Sebas-Muriel/WarehouseRobot/Helpful Documents/Useful_links.txt

https://pinout.xyz/pinout/i2c
Useful for looking at the pinout diagrams for the Pi. This specific page is for I2C.

https://www.teachmemicro.com/raspberry-pi-serial-uart-tutorial/
Raspberry Pi QR scan code: 
https://www.hackster.io/gatoninja236/scan-qr-codes-in-real-time-with-raspberry-pi-a5268b

To get Camera working use this in terminal:

sudo chmod a+rw /dev/i2c-*
