Sebas-Muriel/WarehouseRobot/Senior Design Webmaster/vdrs/VDR3.pptx

Team Members: Alexandar Jen, Walter Caldwell, Sebastian Muriel, Tiffany Miller, Tony Zheng
Instructors: Dr. Oscar Chuy & Dr. Jerris Hooker Faculty Advisor: Dr. Bruce Harvey

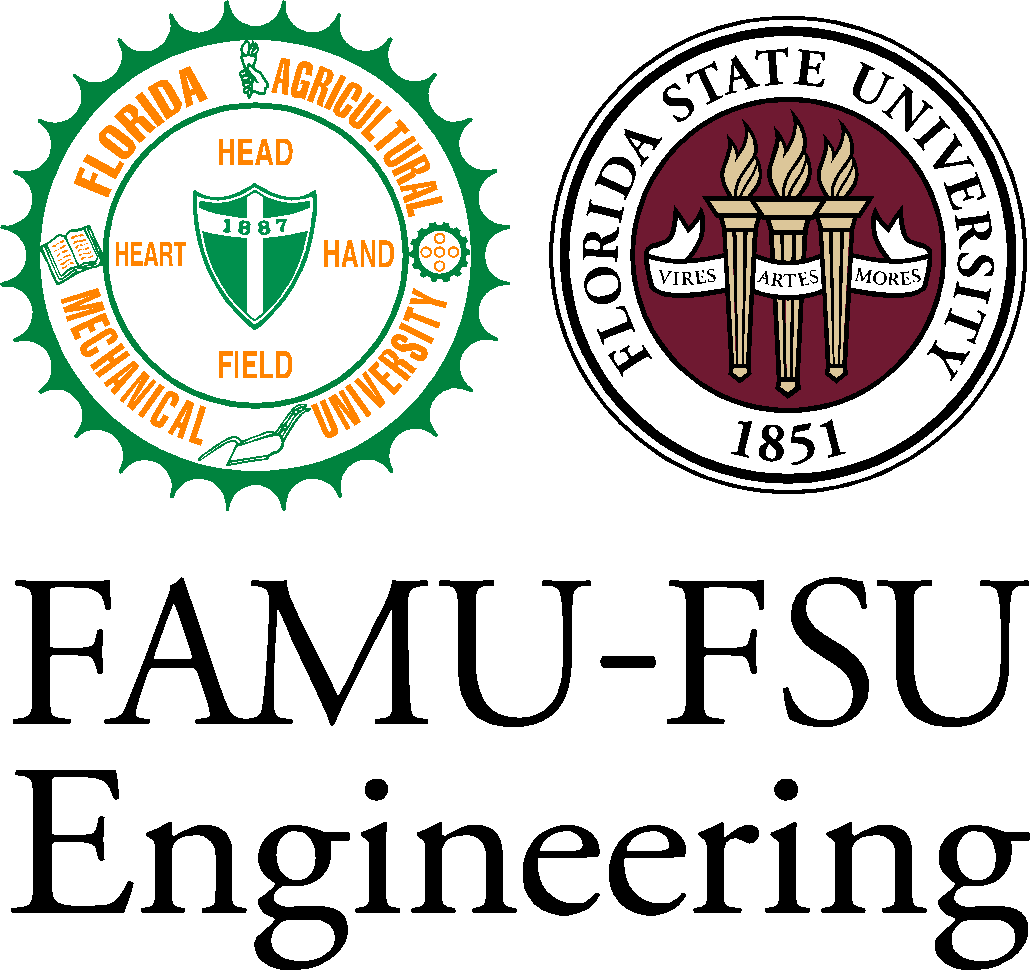
[picture p10: figure]

T311 - Material Handling Robot

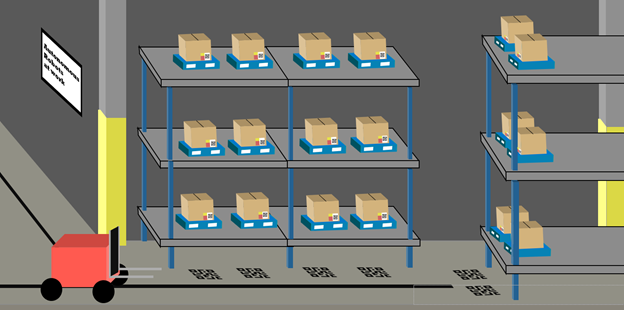
[picture p11: figure]

Objective:
The objective of this project is to create a partially autonomous material handling robot that works in a dark warehouse with conditions unfavorable to human workers.

Abstract

There is a demand for robotic workers in warehouses for the purpose of increasing productivity and reducing worker liability. Since the main goal is to reduce the number of human workers to zero, an autonomous fleet of robots is an ideal workforce. Thus, the purpose of this project is to create an autonomous robot that can manipulate inventory around the warehouse.

Design

An Arduino Due will be used to control the motors
A raspberry pi will be used to control navigation with a line sensor. It will also control the camera module to identify packages and update inventory.

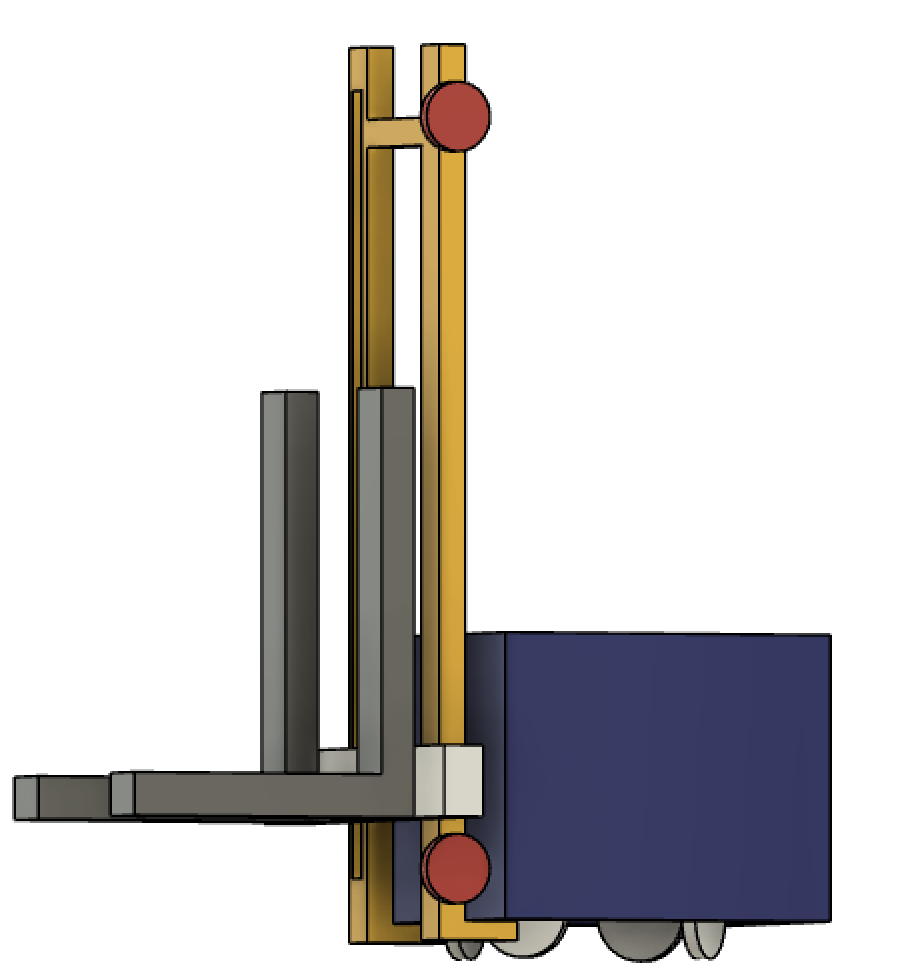
[picture p12: figure]

Problem

- Warehouses need to increase productivity to meet increasing demands.
- Worker injuries need to be reduced as well as employee turnover.
- Current robotic alternatives are expensive and too large.

Block Diagram

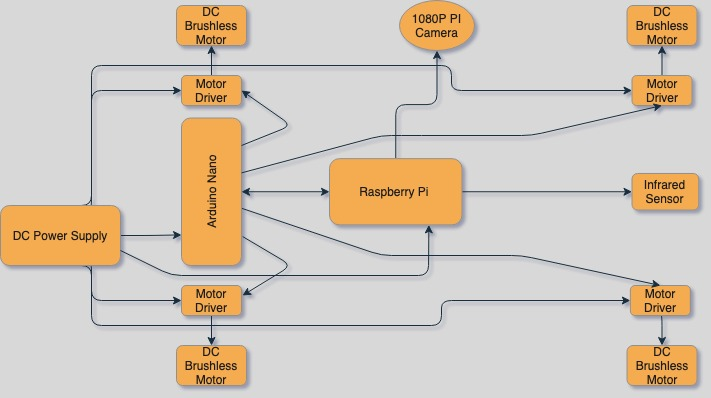
[picture p13: figure]

Scope

Load of 25 lb
Navigates autonomously
Recognizes packages
Self-loading and dropoff

Future Work

- Assemble prototype
- Test prototype movement and lifting mechanisms with manual inputs
- Design navigation and databasing algorithms
- Test algorithms and prototype’s autonomous movements

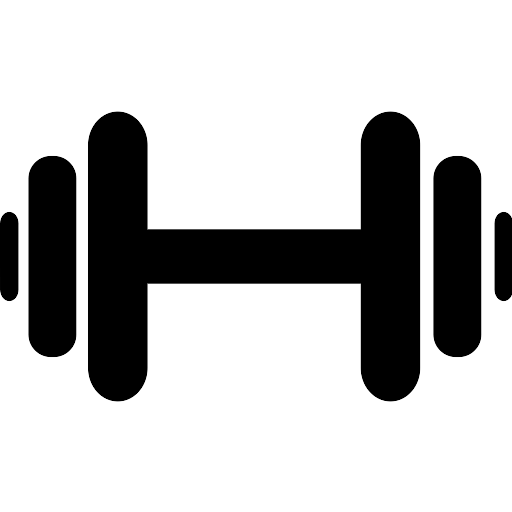
[picture p14: figure]
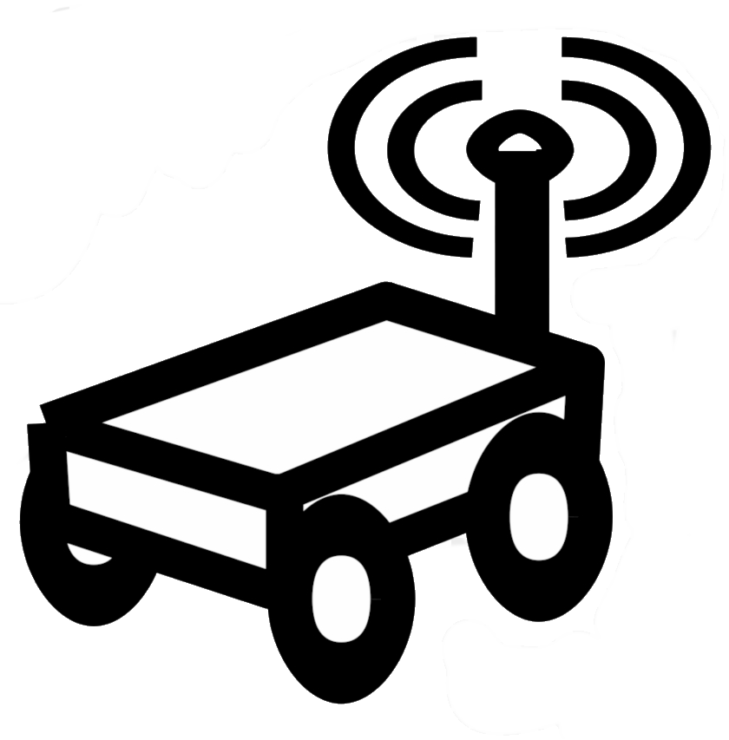
[picture p15: figure]
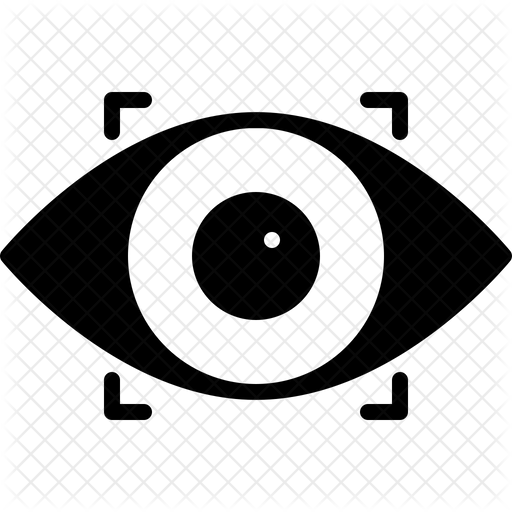
[picture p16: figure]
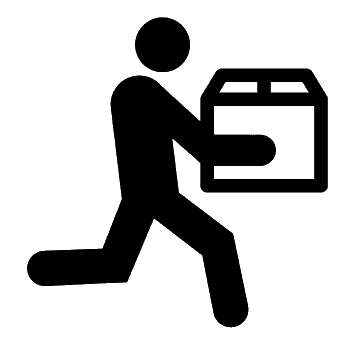
[picture p17: figure]

Notes: https://ww2.eng.famu.fsu.edu/me/senior_design/2017/team22/docs_pdfs/FinalPoster.pdf
