Sebas-Muriel/WarehouseRobot/Senior Design Webmaster/images/Chart.png

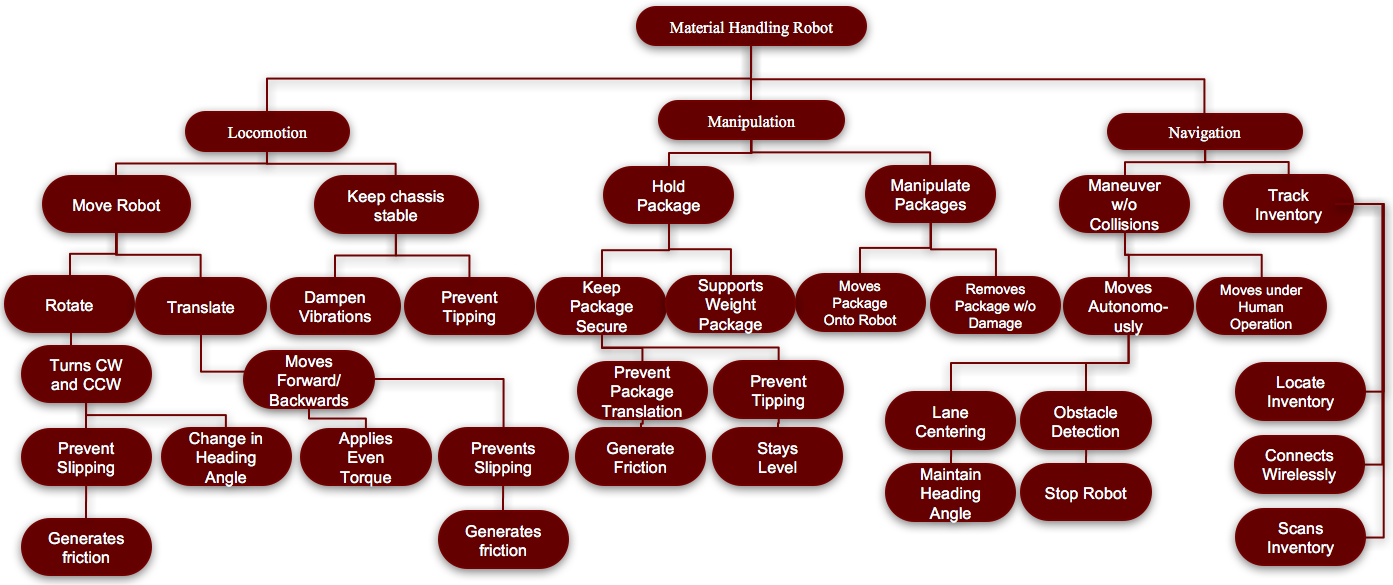
Senior Design Webmaster/images/Chart.png
