Sebas-Muriel/WarehouseRobot/Senior Design Webmaster/images/McConomy.png

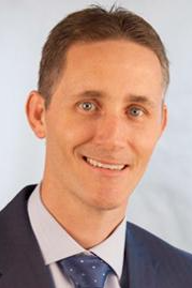
Senior Design Webmaster/images/McConomy.png
