Sebas-Muriel/WarehouseRobot/Senior Design Webmaster/images/NeedsTable.png

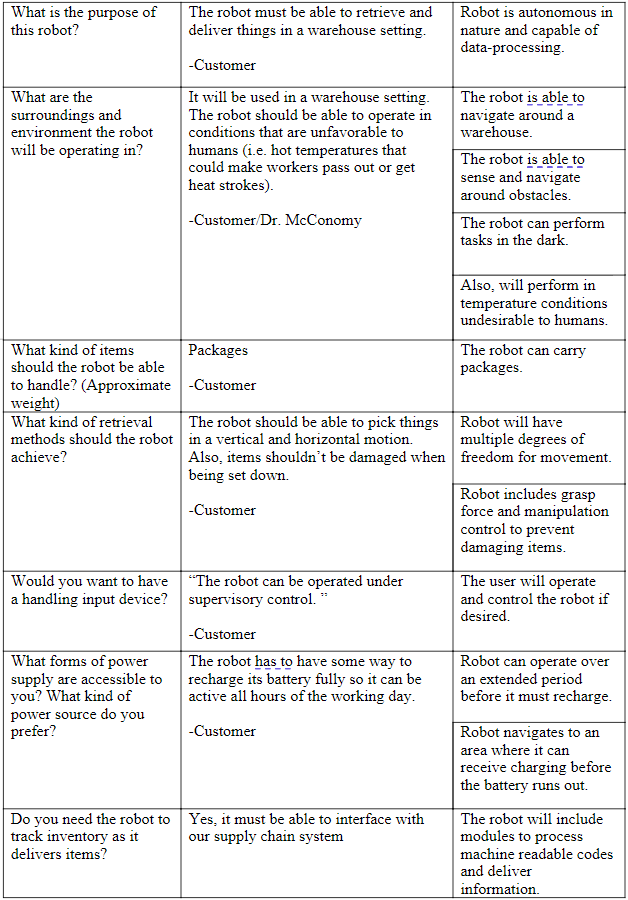
Senior Design Webmaster/images/NeedsTable.png
