Sebas-Muriel/WarehouseRobot/Senior Design Webmaster/images/Ordonez.png

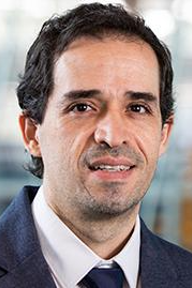
Senior Design Webmaster/images/Ordonez.png
