Sebas-Muriel/WarehouseRobot/Senior Design Webmaster/images/Robot.png

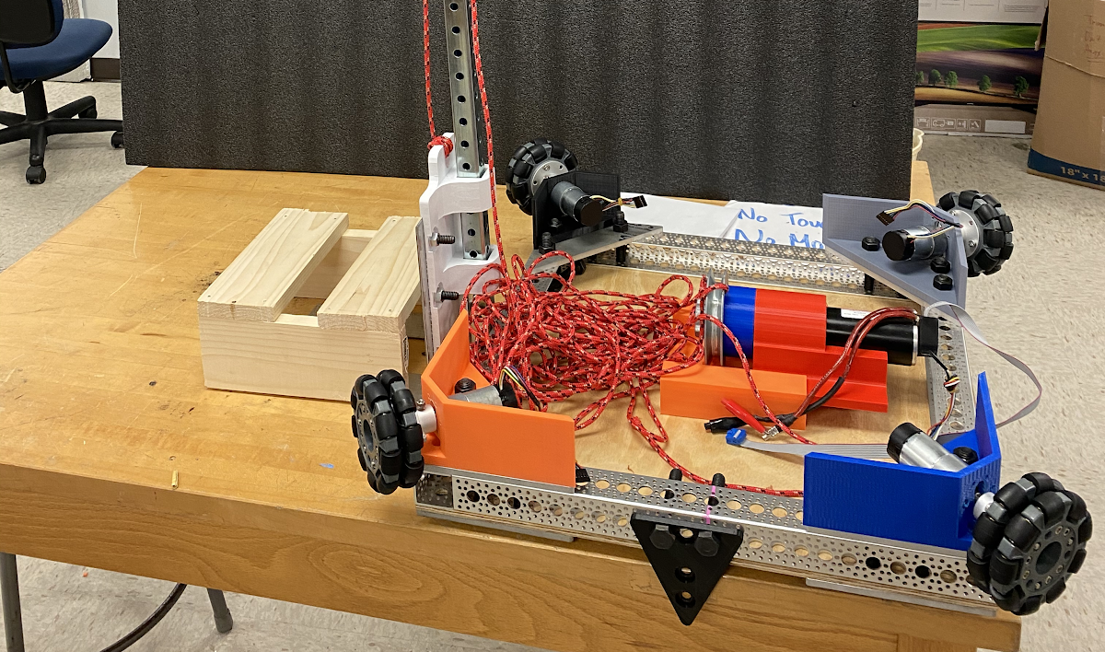
Senior Design Webmaster/images/Robot.png
