Sebas-Muriel/WarehouseRobot/Senior Design Webmaster/images/Targets.png

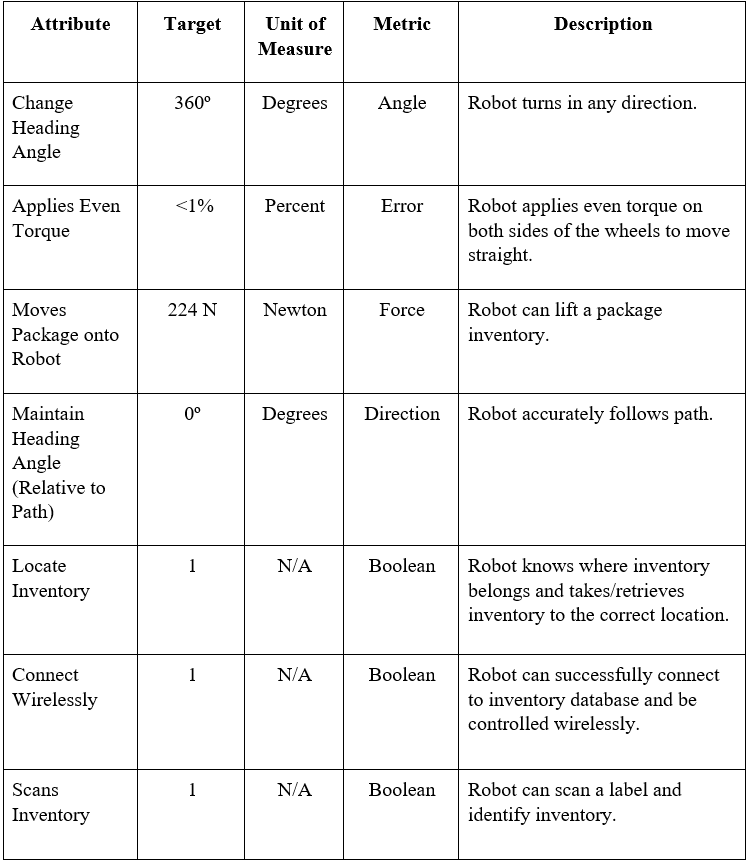
Senior Design Webmaster/images/Targets.png
