Sebas-Muriel/WarehouseRobot/MotorController/alex_omni/alex_omni.ino

#include "robot.h" // low level functions
#include <Time.h>
#include <TimeLib.h>
// Libraries:-
#include <Wire.h>

//Slave Addresses for I2C
#define IR_I2C 0x09

//Defines for movement
#define STOP 0x00
#define LEFT 0X01
#define RIGHT 0X02
#define UP 0x03
#define DOWN 0x04

#define RESET_MODE 0x00
//Defines for Modes 
#define NODE_MODE 0x01
#define TICK_MODE 0x02

//defines for pins
#define MRDY 0x06
#define SRDY 0x07
#define CAMLED 0x09
#define PILEDCONTROL 10

//defines for Motor Movement
#define MOTOR_STOP 0x00
#define MOTOR_LEVEL1 0x01
#define MOTOR_LEVEL2 0x02
  #define MOTOR_LEVEL3 0x04
  #define MOTOR_LIFT 0x03

#define BaseFloor .00
#define Floor1 .04
#define pickup .1

unsigned long ticks = 0; 

float goal[2] = {5.0, 0.0};

float vxMax = 0.15;      
float vyMax = 0.15;
float thetaDotMax = 1.00;

float count = 1;
float errorEnc0 = 0, errorEnc1 = 0;
float SumErrorEnc0 = 0, SumErrorEnc1 = 0;
float avgErrorEnc0 = errorEnc0, avgErrorEnc1 = errorEnc1;

uint8_t I2C_IR_Values[4] = {0,0,0,0};
uint8_t v_up[8], v_down[8], h_left[8], h_right[8], s_stop[8];
time_t start, current;
float xposStart = 0, xposCurrent = 0, yposStart = 0, yposCurrent = 0;
uint8_t NodeIntersectionFLG = 0, TickIntersectionFLG = 0, ForkFLG = 0;
char node = 'l', tick ='l';

float absforkLevel = .05;

uint8_t dir = STOP;
uint8_t motor = MOTOR_STOP;
uint8_t mode = RESET_MODE;
uint8_t UART_RX;
uint8_t MRDY_VAL;
char dirPID = 's';
char forkDir = 's';
uint8_t PiLED;

/*
 * UART_REC() 
 * Triggered by MRDY and reads the 8bit message that the PI sends.
 * It then parses that message and stores the data into dir/mode/motor
*/
void UART_REC();
/*
 * binToArray
 * takes in an 8bit binary number and converts it to an array of 8 indexes.
 * It then filters the array for outlying 1's
 */
uint8_t binToArray(uint8_t bin, uint8_t * arr);
/*
 * UART_TX
 * Sends the message to the pi on the Serial cable.
 */
void UART_TX(uint8_t message);
/*
 * Control
 * Runs the Omniwheel PI controls to move the robot.
 * Takes in a front and back sensor for line sensing PI controlls as well.
 */
void Control (uint8_t *front, char d, uint8_t *back);
/*
 * CopyArr
 * Takes in the src array and copies the values to the des array.
 */
void CopyArr(uint8_t *src, uint8_t *des);
/*
 * Array2Bin
 * Converts an array of 1's and 0's to an 8bit number containing the 1's and 0's.
 */
uint8_t Array2Bin(uint8_t values[]);
/*
 * lineLogic
 * returns true if it the line sensor reads any value with 0xF0 in it.
 */
bool lineLogic(uint8_t IR_Sens);

void setup() {
  Serial.begin(9600);
  Wire.begin();
  pinMode(MRDY, INPUT);
  attachInterrupt(digitalPinToInterrupt(MRDY), UART_REC, FALLING);
  pinMode(SRDY, OUTPUT);
  pinMode(CAMLED, OUTPUT);
  pinMode(PILEDCONTROL, INPUT);
  digitalWrite(CAMLED, HIGH);
  digitalWrite(SRDY, HIGH);
  startTimer(TC1, 0, TC3_IRQn, 100); //TC1 channel 0, the IRQ for that channel and the desired frequency
  encoder_init();
  pwm_init();
  // init sensor stuff

// Set pins connected to motor drivers as outputs (DUE version of DDRC)
  REG_PIOC_OWER = 0x00000FFF;     // Enable writes to lowest 4-bits of PortD's 32-bit, Output Data Status (ODSR) register: (B00000000000000000000111111111111)
  REG_PIOC_OER =  0x00000FFF;     // Set the lowest 4-bits of PortD to outputs: (B00000000000000000000111111111111)
  
  dir = STOP;
}


void loop() {

  PiLED = digitalRead(PILEDCONTROL);
  if (PiLED == HIGH)
  {
    digitalWrite(CAMLED, LOW);
  }
  else
  {
    digitalWrite(CAMLED, HIGH);
  }
  
  switch(dir)
  {
    case UP:    des_robot_vel[0] = vxMax; des_robot_vel[1] = 0; dirPID = 'u'; break;
    case DOWN:  des_robot_vel[0] = -vxMax; des_robot_vel[1] = 0; dirPID = 'd'; break;
    case LEFT:  des_robot_vel[0] = 0.0; des_robot_vel[1] = vyMax; dirPID = 'l'; break;
    case RIGHT: des_robot_vel[0] = 0.0; des_robot_vel[1] = -vyMax; dirPID = 'r'; break;
    case STOP:  des_robot_vel[0] = 0.0; des_robot_vel[1] = 0.0; dirPID = 's'; break;
  }
  count++;


}

/*****************************************************************************/


/*************************  Control Function        ***************************/

void Control (uint8_t *front, char d, uint8_t *back, char LiftDir, float desHeight, char dirPID)
{
  int flagRad; // flag to decide the type of required turn

  // wait 3 seconds to start moving
  if ( (ticks <= 300) ) {
    des_robot_vel[0] = 0.0;
    des_robot_vel[1] = 0.0;
    desForkVel = 0.0;
  }

  GetCurrentStatus();
  Motor_Control(front, d, back, LiftDir, desHeight, dirPID);
  ticks++;
  

}
/*
 * First the SRDY line to the Pi is pulled low and then it waits for the
 * MRDY from the pi to go low. Then the Pi sends the message over the UART
 * channel. The message is then read and parsed for the instructions.
 * After the sending is complete the Arduino pulls SRDY high to let the Pi know it's finished.
 */
void UART_REC()
{
  
  digitalWrite(SRDY, LOW);
  xposStart = 0;
  xposCurrent = 0;
  yposStart = 0;
  yposCurrent = 0;
  NodeIntersectionFLG = 0;
  while(digitalRead(MRDY) == LOW)
  {
    if (Serial.available() >= 1)
    {
       UART_RX = Serial.read();
//       Serial.println(UART_RX);
       dir = (UART_RX&0b00011100)>>2;
       mode = (UART_RX&0x03);
       motor = (UART_RX&0b11100000)>>5;
    }
  }
 digitalWrite(SRDY, HIGH);
}

/*
 * Prints a message with a new line after it on the UART channel.
 */
void UART_TX(char message)
{
  Serial.println(message);  
}

/*
 * specific values are defined for each array index that correspond to
 * a binary number. 
 * If there is a one it is added to the 8bit number.
 * If it is a zero nothing happens.
 */
uint8_t Array2Bin(uint8_t values[])
{
  uint8_t returnValue = 0x00;
  uint8_t adder = 0x00;
  for (int i =0; i < 8; i++)
  {
    switch(i)
    {
      case 0: adder = 0x01; break;
      case 1: adder = 0x02; break;
      case 2: adder = 0x04; break;
      case 3: adder = 0x08; break;
      case 4: adder = 0x10; break;
      case 5: adder = 0x20; break;
      case 6: adder = 0x40; break;
      case 7: adder = 0x80; break;
    }
    if (values[i] == 1)
      returnValue += adder;
  }
  return returnValue;
}
/*
 * Uses a bit and ANDs it with each bit of the 8bit number.
 * Then adds that value to the array index and the ANDed number 
 * is left shifted until it reaches 7.
 * 
 * Then a filter is used to get rid of outlying data that the
 * sensors pick up by accident. It finds the largest number of 1's in a group.
 * Then converts everything else but that largest group into 0's.
 * Then it returns an 8bit number of the converted value.
 */
uint8_t binToArray(uint8_t bin, uint8_t * arr)
{
  uint8_t mask = 1;

  for (int i = 0, j =7; i < 8; i++)
  {
    arr[j] = (bin&mask)>>i;
    mask = mask<<1;
    j--;
  }
//Filter to get rid of noise prioritizes the middle area
  uint8_t count = 0;
  uint8_t indexOfOnes = 0;
  uint8_t largestOnes = 0;
  uint8_t largestIndex = 10;
  bool many = false;
  for (int i =0 ; i < 8; i++)
  {
    if (arr[i] == 1)
    {
      if (many == false)
        indexOfOnes = i;
      count++;
      many = true;
    }

    if (arr[i] == 0)
    {
      many = false;
      if (largestOnes <= count)
      {
        if (abs(indexOfOnes- 3) < abs(largestIndex -3))
        {
          largestOnes = count;
          largestIndex = indexOfOnes;
        }
      }
      count = 0;
    }
  }
  if (arr[7] == 1)
  {
      if (largestOnes <= count)
      {
        if (abs(indexOfOnes- 3) < abs(largestIndex -3))
        {
          largestOnes = count;
          largestIndex = indexOfOnes;
        }
      }
  }
  count = 0;
  for (int i =0; i < 8; i++)
  {
    if (i >= largestIndex && count < largestOnes)
    {
      arr[i] = 1;
      count++;
    }
    else
    {
      arr[i] = 0;                                                                                                                               
    }
  }

  return Array2Bin(arr);
}
/*
 * Copis the src into the des array.
 */
void CopyArr(uint8_t *src, uint8_t *des)
{
  for (int i =0 ; i < 8; i++)
  {
    des[i] = src[i];
  }
}
/*
 * If the IR sensor is >= F0 then it returns true
 */
bool lineLogic(uint8_t IR_Sens)
{
  for (int i =0 ; i < 16; i++)
  {
    if (IR_Sens == (0xF0 + i))
      return true;
  }
  return false;
}
/*****************************************************************************/
// 100 Hz timer
void TC3_Handler()
{
  TC_GetStatus(TC1, 0);
//*************************************************************************//
//******************************GET IR SENSOR DATA*************************//
//*************************************************************************//


  /*Sends in order
   * 0 Up sensor
   * 1 Back sensor
   * 2 Left sensor
   * 3 Right sensor
   * Requests information from the Arduino Mega. The Mega sends 4 over they
   * are read in the format above.
   * A 1 means a black line and a 0 means a white line.
  */
  Wire.requestFrom(IR_I2C, 4);
  if (Wire.available() >= 1){
    for (int i = 0; i < 4; i++)
    {
      I2C_IR_Values[i] = Wire.read();
    }
    
    //The values from the IR sensor are filtered for noise and converted into an array for each value.
    I2C_IR_Values[0] = binToArray(I2C_IR_Values[0], v_up);
    I2C_IR_Values[1] = binToArray(I2C_IR_Values[1], v_down);
    I2C_IR_Values[2] = binToArray(I2C_IR_Values[2], h_left);
    I2C_IR_Values[3] = binToArray(I2C_IR_Values[3], h_right);

//    I2C_IR_Values[3] &= ~0b10000001;
//    I2C_IR_Values[3] = binToArray(I2C_IR_Values[3], h_right);
//    Serial.println
//   Serial.print("[]");
//   Serial.println(I2C_IR_Values[0], BIN);       
  }

//*************************************************************************//
//******************************Mode Reset*********************************//
//*************************************************************************//
  if (mode == RESET_MODE)
  {
    dir = STOP;
    for (int i =0 ; i < 8; i++)
    s_stop[i] = 0;
    NodeIntersectionFLG = 0;
    TickIntersectionFLG = 0;
//    motor = MOTOR_LEVEL1;
    xposStart = 0;
    xposCurrent = 0;
    yposStart = 0;
    yposCurrent = 0;
  }
//*************************************************************************//
//******************************Start NODE MODE****************************//
//*************************************************************************//
  else if(mode == NODE_MODE)
  {
    /*
     * Each direction has the same format for Node mode. They use the values from the 
     * I2C request above.
     * They each have an action when the sensor equals:
     * 0xFF
     * 0xF0
     * There are some extra logic to make it less sensitive such as F8 or FE in case the sensor is off.
     * Before it stops the robot moves so its center of its body is on the cross section.
     */
    if (dir == LEFT)
    {
      //Start Stopping process once a black line is hit
      if (I2C_IR_Values[2] == 0xFF && NodeIntersectionFLG == 0)
      {
        //Take position at the line
        xposStart = robot_pos[1];  
        Serial.println("S");                       
        NodeIntersectionFLG = 1;
      }
      if (NodeIntersectionFLG == 1)
      {
        I2C_IR_Values[2] = 0b00011000;
        binToArray(I2C_IR_Values[2], h_left);
        binToArray(I2C_IR_Values[2], h_right);
      }
      
      //If a tick is hit
      if (I2C_IR_Values[2] == 0xF0 || I2C_IR_Values[2] == 0xF8)
      {
        //Change the values that are being checked and change the array that needs to be sent to 
        //the line sensing PI controller.
        I2C_IR_Values[2] = 0b00011000;
        binToArray(I2C_IR_Values[2], h_left);
      }
      //Repeatedly take current position
      
      xposCurrent = robot_pos[1];
      
      //Stop the robot once the stopping process begins and after the robot travels its distance in the x direction
      if (abs(abs(xposCurrent) - abs(xposStart)) >= ((robotLength)/ 2)-.06 && NodeIntersectionFLG == 1)
      {
        dir = STOP;
        CopyArr(h_left, s_stop);
        UART_TX('1'); 
      }
    }
    else if(dir == RIGHT)
    {
//      Serial.println(I2C_IR_Values[3], BIN);
      //Start Stopping process once a black line is hit
      if (I2C_IR_Values[3] == 0xFF && NodeIntersectionFLG == 0)
      {
        xposStart = robot_pos[1];  
        Serial.println("S");                                                               
        NodeIntersectionFLG = 1;
      }
      //Ignore Ticks
      if (I2C_IR_Values[3] == 0xF0 || I2C_IR_Values[3] == 0xF8)
      {
        I2C_IR_Values[3] = 0b00011000;
        binToArray(I2C_IR_Values[3], h_right);
      }
      if (NodeIntersectionFLG == 1)
      {
        I2C_IR_Values[3] = 0b00011000;
        binToArray(I2C_IR_Values[3], h_left);
        binToArray(I2C_IR_Values[3], h_right);
      }
      xposCurrent = robot_pos[1];
      //Stop the robot once the stopping process begins and after the robot travels its distance in the x direction
      if (abs(abs(xposCurrent) - abs(xposStart)) >=  ((robotLength)/2)-.06 && NodeIntersectionFLG == 1)
      {
        dir = STOP;
        CopyArr(h_right, s_stop);
        UART_TX('1');
      }   
    }
    else if(dir == UP)
    {
      //Start Stopping process once a black line is hit
      if (I2C_IR_Values[0] == 0xFF /*|| I2C_IR_Values[0] == 0xFE || I2C_IR_Values[0] == 0x7F)*/ && NodeIntersectionFLG == 0)
      {
        yposStart = robot_pos[0];
        Serial.println("S");   
        NodeIntersectionFLG = 1;
      }
      yposCurrent = robot_pos[0];

      //Stop the robot once the stopping process begins and after the robot travels its distance in the x direction
      if (NodeIntersectionFLG == 1)
      {
        I2C_IR_Values[1] = 0b00011000;
        binToArray(I2C_IR_Values[1], v_down);
        binToArray(I2C_IR_Values[1], v_up);
      }

      if (abs(abs(yposCurrent) - abs(yposStart)) >= ((robotLength)/ 2)-.05 && NodeIntersectionFLG == 1)
      {
        dir = STOP;
        CopyArr(v_up, s_stop);
        UART_TX('1');
      }
    }
    else if(dir == DOWN)
    {
      //Start Stopping process once a black line is hit
      if (I2C_IR_Values[1] == 0xFF && NodeIntersectionFLG == 0)
      {
        yposStart = robot_pos[0];
        Serial.println("S");   
        NodeIntersectionFLG = 1;
      }
      yposCurrent = robot_pos[0];
      if (NodeIntersectionFLG == 1)
      {
        I2C_IR_Values[1] = 0b00011000;
        binToArray(I2C_IR_Values[1], v_down);
        binToArray(I2C_IR_Values[1], v_up);
      }
      //Stop the robot once the stopping process begins and after the robot travels its distance in the x direction
      if (abs(abs(yposCurrent) - abs(yposStart)) >= ((robotLength)/ 2)-.06 && NodeIntersectionFLG == 1)
      {
        dir = STOP;
        CopyArr(v_down, s_stop);
        UART_TX('1');
      }
    }
  }
//*************************************************************************//
//******************************Start Tick Mode****************************//
//*************************************************************************//
  else if(mode == TICK_MODE)
  {
    /*
     * Each direction has the same format for Tick mode. They use the values from the 
     * I2C request above.
     * They each have an action when the sensor equals:
     * 0xFF
     * 0xF0
     * There are some extra logic to make it less sensitive such as F8 or FE in case the sensor is off.
     * Before it stops the robot moves so its center of its body is on the cross section.
     * 
     * When the robot notices a tick it will send a 2 to the Pi and when it notices a node it will send 
     * a 1 to the pi. Besides that everything is the same as Node Mode
     */
    if (dir == LEFT)
    {
      //Start Stopping process once a tick is hit
      if ((I2C_IR_Values[2] == 0xF0 || I2C_IR_Values[2] == 0xF8) && NodeIntersectionFLG == 0)
      {
        xposStart = robot_pos[1];
        NodeIntersectionFLG = 1;
        I2C_IR_Values[3] = 0b00011000;
        binToArray(I2C_IR_Values[2], h_left);
        Serial.println("T");
        tick = 'T';
      }
      else if ((I2C_IR_Values[2] == 0xFF || I2C_IR_Values[2] == 0xFE || I2C_IR_Values[2] == 0x8F) && NodeIntersectionFLG == 0)
      {
        xposStart = robot_pos[1];
        NodeIntersectionFLG = 1;
        I2C_IR_Values[3] = 0b00011000;
        binToArray(I2C_IR_Values[2], h_left);
        Serial.println("N");
        tick = 'N';
      }
      xposCurrent = robot_pos[1];
      //Stop the robot once the stopping process begins and after the robot travels its distance in the x direction
      if (abs(abs(xposCurrent )- abs(xposStart)) >= ((robotLength)/ 2.0)-.06 && NodeIntersectionFLG == 1)
      {
        dir = STOP;
        CopyArr(h_left, s_stop);
        if (tick == 'N')
          UART_TX('1');
        else if(tick == 'T')
          UART_TX('2');
      }   
    }
    else if(dir == RIGHT)
    {
      //Start Stopping process once a tick is hit
      if ((I2C_IR_Values[3] == 0xF0 || I2C_IR_Values[3] == 0xF8) && NodeIntersectionFLG == 0)
      {
        xposStart = robot_pos[1];
        NodeIntersectionFLG = 1;
        I2C_IR_Values[3] = 0b00011000;
        binToArray(I2C_IR_Values[3], h_right);
       Serial.println("T");
        tick = 'T';
      }
      else if ((I2C_IR_Values[3] == 0xFF || I2C_IR_Values[3] == 0xFE || I2C_IR_Values[3] == 0x8F) && NodeIntersectionFLG == 0)
      {
        xposStart = robot_pos[1];
        NodeIntersectionFLG = 1;
        I2C_IR_Values[3] = 0b00011000;
        binToArray(I2C_IR_Values[3], h_right);
        Serial.println("N");
        tick = 'N';
      }
      xposCurrent = robot_pos[1];
      //Stop the robot once the stopping process begins and after the robot travels its distance in the x direction
      if (abs(abs(xposCurrent )- abs(xposStart)) >= ((robotLength)/ 2.0)-.03 && NodeIntersectionFLG == 1)
      {
        dir = STOP;
        CopyArr(h_right, s_stop);
        if (tick == 'N')
          UART_TX('1');
        else if(tick == 'T')
          UART_TX('2');
      }   
    }
    else if(dir == UP)
    {
      //Start Stopping process once a black line is hit
      if (I2C_IR_Values[0] == 0xFF /*|| I2C_IR_Values[0] == 0xFE || I2C_IR_Values[0] == 0x7F)*/ && NodeIntersectionFLG == 0)
      {
        yposStart = robot_pos[0];
        NodeIntersectionFLG = 1;
      }
      yposCurrent = robot_pos[0];

      //Stop the robot once the stopping process begins and after the robot travels its distance in the x direction

      if (abs(abs(yposCurrent) - abs(yposStart)) >= .05 && NodeIntersectionFLG == 1)
      {
        dir = STOP;
        CopyArr(v_up, s_stop);
        UART_TX('1');
      }
    }
  }
//*************************************************************************//
//******************************MOTOR**************************************//
//*************************************************************************//
//
  
  if (ForkFLG == 0)
  {
    if (motor == MOTOR_STOP)
    {
      ForkFLG = 0;
    }
    else if(motor == MOTOR_LEVEL1)
    {
      forkDir = 'd';
      absforkLevel = BaseFloor;
      ForkFLG = 1;
  
    }
    else if(motor == MOTOR_LEVEL2)
    {
      absforkLevel = Floor1;
      if (absforkLevel > forkHeight){ forkDir = 'u';}
      else if(absforkLevel < forkHeight) {forkDir = 'd';}
      ForkFLG = 1;
    }
    else if(motor == MOTOR_LEVEL3)
    {
      absforkLevel = Floor1+.1905;
      if (absforkLevel > forkHeight){ forkDir = 'u';}
      else if(absforkLevel < forkHeight) {forkDir = 'd';}
      ForkFLG = 1;
    }
    else if(motor == MOTOR_LIFT)
    {
      forkDir = 'u';
      absforkLevel += pickup;
      ForkFLG = 1;
    }
  }
  if (forkDir == 'u')
  {
    if (ForkFLG == 1 && absforkLevel <= forkHeight)
    {
      UART_TX('3');
      ForkFLG =0;
      motor = MOTOR_STOP;
    }
  }
  else if(forkDir == 'd')
  {
    if (ForkFLG == 1 && absforkLevel >= forkHeight)
    {
      UART_TX('3');
      ForkFLG =0;
      motor = MOTOR_STOP;
    }
  }
  
//  Serial.println(encoder_val[4]);
//  Serial.println(forkHeight);

//*************************************************************************//
//******************************Controller*********************************//
//*************************************************************************//
  switch(dir)
  {
    case LEFT: Control(h_left, 'l', h_right, forkDir, absforkLevel, dirPID); break;
    case RIGHT: Control(h_right, 'l', h_left, forkDir, absforkLevel, dirPID); break;
    case UP: Control(v_up, 'u', v_down, forkDir, absforkLevel, dirPID); break;
    case DOWN: Control(v_down, 'u', v_up, forkDir, absforkLevel, dirPID); break;
    case STOP: Control(s_stop,'s', s_stop, forkDir, absforkLevel, dirPID); break;
  }
}
/********************************************************************/
