Sebas-Muriel/WarehouseRobot/Navigation/ServoKit.py

# encoding: UTF-8
'''
    Copyright (c) 2020-8 Arducam <http://www.arducam.com>.

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
    THE SOFTWARE IS PROVIDED "AS IS", WITHOUT WARRANTY OF ANY KIND,
    EXPRESS OR IMPLIED, INCLUDING BUT NOT LIMITED TO THE WARRANTIES OF
    MERCHANTABILITY, FITNESS FOR A PARTICULAR PURPOSE AND NONINFRINGEMENT.
    IN NO EVENT SHALL THE AUTHORS OR COPYRIGHT HOLDERS BE LIABLE FOR ANY CLAIM,
    DAMAGES OR OTHER LIABILITY, WHETHER IN AN ACTION OF CONTRACT, TORT OR
    OTHERWISE, ARISING FROM, OUT OF OR IN CONNECTION WITH THE SOFTWARE OR THE USE
    OR OTHER DEALINGS IN THE SOFTWARE.
'''




import time
import adafruit_servokit
import cv2


class ServoKit(object):
    default_angle = 90

    def __init__(self, num_ports):
        print("Initializing the servo...")
        self.kit = adafruit_servokit.ServoKit(channels=16)
        self.num_ports = num_ports
        self.resetAll()
        print("Initializing complete.")

    def setAngle(self, port, angle):
        if angle < 0:
            self.kit.servo[port].angle = 0
        elif angle > 180:
            self.kit.servo[port].angle = 180
        else:
            self.kit.servo[port].angle = angle
    
    def getAngle(self, port):
        return self.kit.servo[port].angle

    def reset(self, port):
        self.kit.servo[port].angle = self.default_angle

    def resetAll(self):
        for i in range(self.num_ports):
            self.kit.servo[i].angle = self.default_angle


def test():
    servoKit = ServoKit(4)
    print("Start test")

    servoKit.setAngle(0, 110) #110 first #145 second
    readQR()
    time.sleep(5)

    while(1):
        pass
    servoKit.resetAll()

def readQR():
    # set up camera object
    cap = cv2.VideoCapture(0)

    # QR code detection object
    detector = cv2.QRCodeDetector()
    startTime = time.time()

    while True:
        currentTime = time.time()
        if (currentTime - startTime > 50):
            data = "null"
            cap.release()
            cv2.destroyAllWindows()
            return data
        # get the image
        _, img = cap.read()
        # get bounding box coords and data
        data, bbox, _ = detector.detectAndDecode(img)

        # if there is a bounding box, draw one, along with the data
        if(bbox is not None):
            for i in range(len(bbox)):
                cv2.line(img, tuple(bbox[i][0]), tuple(bbox[(i+1) % len(bbox)][0]), color=(255,
                         0, 255), thickness=2)
            cv2.putText(img, data, (int(bbox[0][0][0]), int(bbox[0][0][1]) - 10), cv2.FONT_HERSHEY_SIMPLEX,
                        0.5, (0, 255, 0), 2)
            if data:
                print("Package: ", data)
                cap.release()
                cv2.destroyAllWindows()
                return data
        # display the image preview
        cv2.imshow("Package detection", img)
        if(cv2.waitKey(1) == ord("q")):
            break
    # free camera object and exit
    cap.release()
    cv2.destroyAllWindows()
    return

if __name__ == "__main__":
    test()
