Sebas-Muriel/WarehouseRobot/(commit log)

2021-02-20 fixed some function calls
    [Nav.py]
2021-02-20 fixed with some colons
    [Nav.py]
2021-02-25 Added Webmaster and edited arduino
2021-02-27 Create WiringPi
2021-03-04 added arudino stuff and uart on pi
2021-03-12 Fixed Nav.py. Added mongogrid
    [Nav.py, test.js]
2021-03-13 added Motor stuff
2021-03-16 added reset and ticksearch and return to start
    [Nav.py]
2021-03-21 fixed issues communicated with motor controller
    [Nav.py, UART.py]
2021-03-21 added new motor controller
2021-03-25 Added Pictures and fixed links
    [Motor_Controller.ino]
2021-03-29 Switched to Mega Configuration
2021-04-03 added filter
2021-04-06 Fixed COntroller and website
    [alex_omni.ino, test.js]
2021-04-12 Arduino Code
2021-04-12 Omni Wheel code
2021-04-14 motor Driver
